Georginatoring/power_EMG_basic/README.md

# power_EMG_basic
Main PCB board for EMG signals
