Georginatoring/power_EMG_basic/V 2.0 EMG FSR/EMG FSR.brd

## EAGLE design V 2.0 EMG FSR/EMG FSR.brd (2021-03-11)

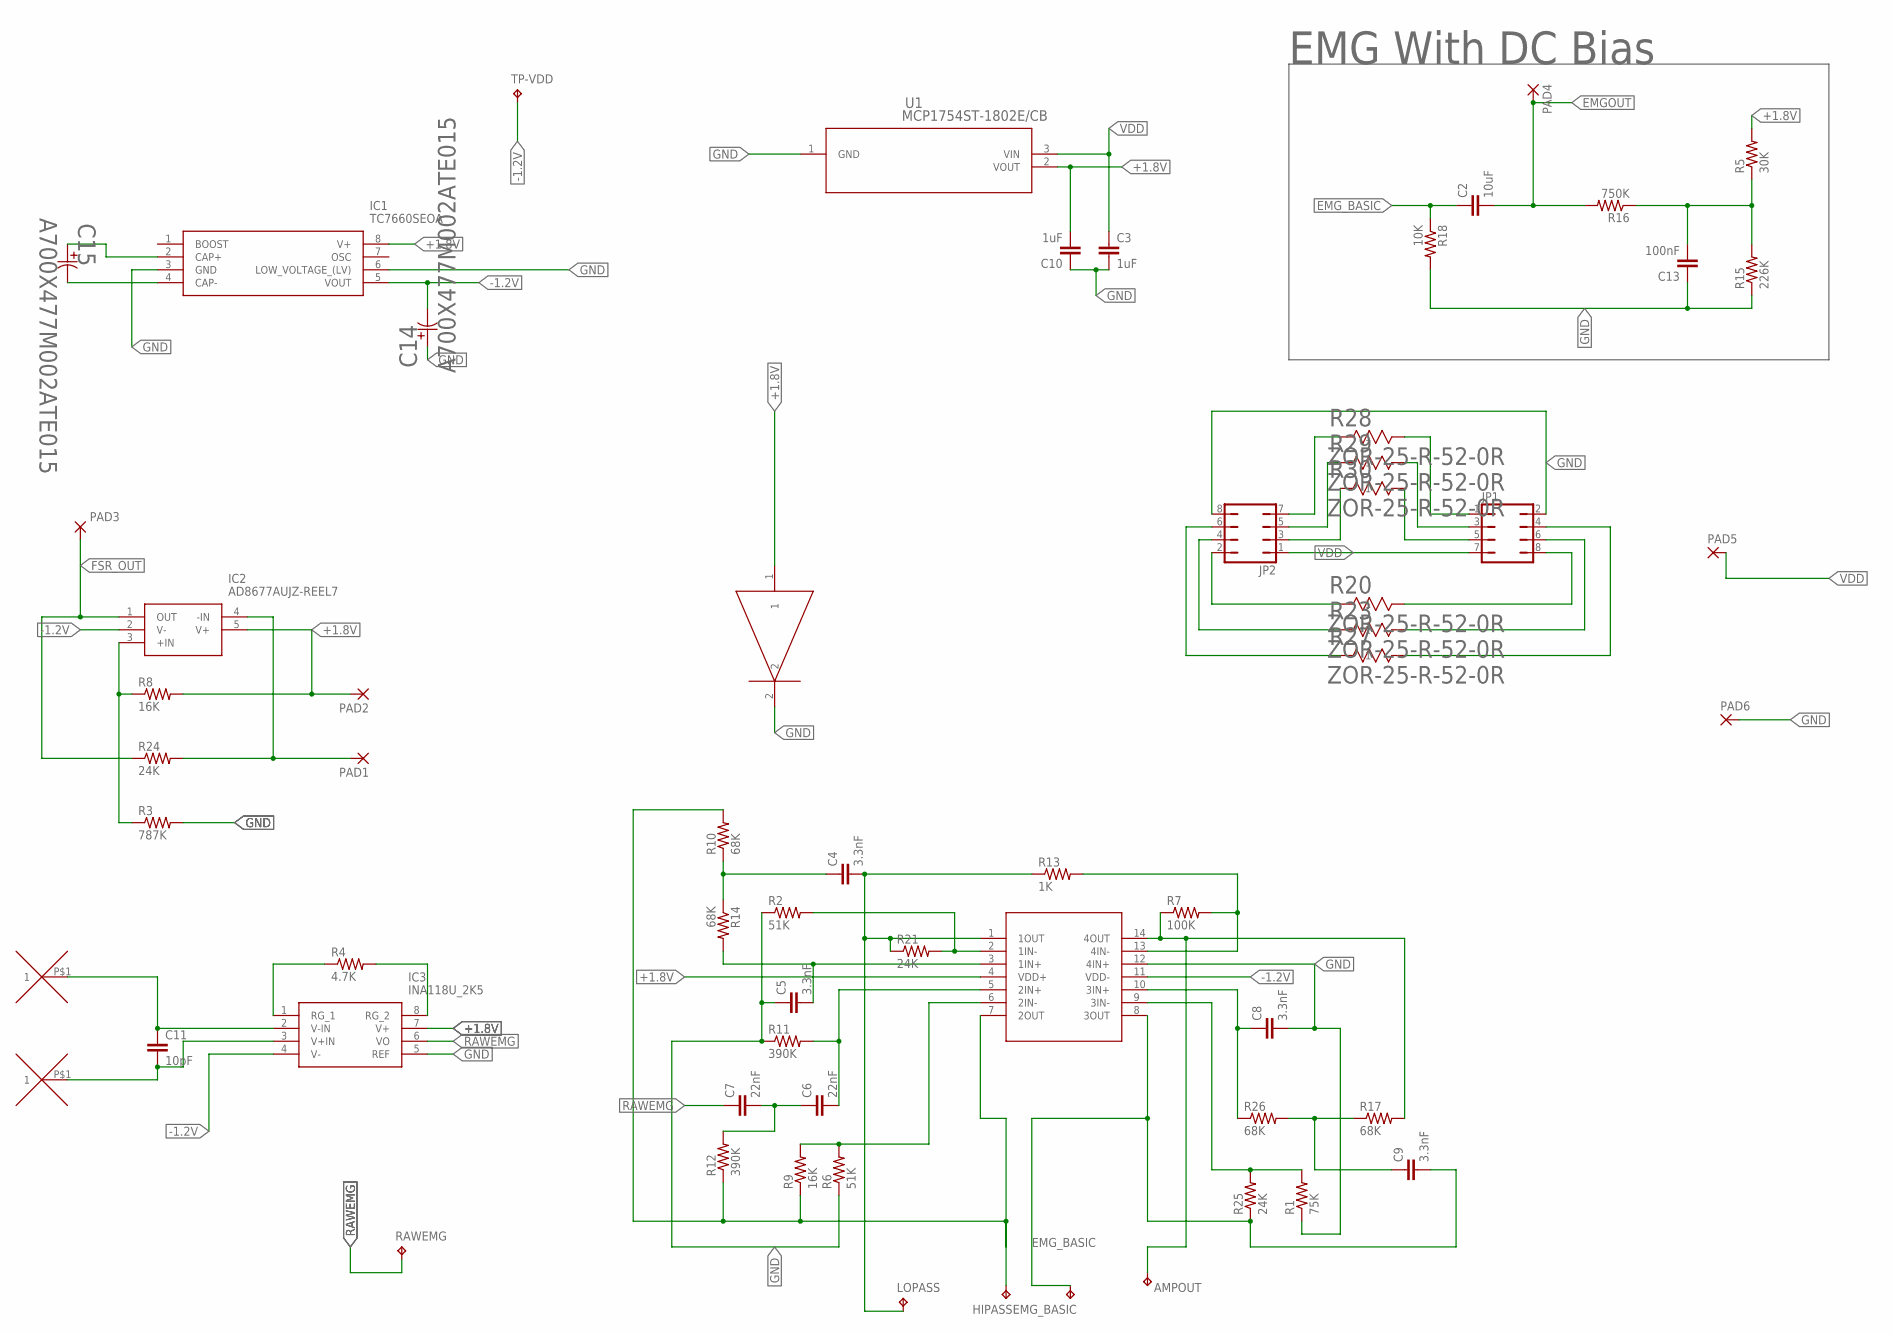
[picture p1: schematic EMG FSR.sch]

Parts:
AMPOUT: TPTP08R; TP08R
C2: 10uF; C0402
C3, C10: 1uF; C0402
C4, C5, C8, C9: 3.3nF; C1206
C6, C7: 22nF; C0805
C11: 10pF; C0402
C13: 100nF; C0402
C14, C15: A700X477M002ATE015; PCAP7343-43_KEMET_KEM
EMG_BASIC: TPTP08R; TP08R
HIPASS: TPTP08R; TP08R
IC1: TC7660SEOA; SOIC127P600X175-8N
IC2: AD8677AUJZ-REEL7; SOT95P280X100-5N
IC3: INA118U_2K5; SOIC127P600X175-8N
JP1, JP2: JP4Q
LOPASS: TPTP08R; TP08R
PAD1, PAD2: SMD2; SMD1,27-2,54
PAD3, PAD4, PAD5, PAD6: 1,6/0,8
R1: 75K; R0402
R2, R6: 51K; R0402
R3: 787K; R0805
R4: 4.7K; R0402
R5: 30K; R0402
R7: 100K; R1005
R8, R9: 16K; R0402
R10, R14, R17, R26: 68K; R0402
R11, R12: 390K; R0603
R13: 1K; R0402
R15: 226K; R0402
R16: 750K; R0402
R18: 10K; R0402
R20, R23, R27, R28, R29, R30: ZOR-25-R-52-0R; RES_ZOR25_6P3X2P3_YAG
R21, R24, R25: 24K; R0402
RAWEMG: TPTP08R; TP08R
RED: RESC0402X40N
TP-VDD: TPTP08R; TP08R
U1: MCP1754ST-1802E/CB; SOT-23A_MC_MCH
U$1: TLC2274-HT; SOP65P640X120-14N
U$2, U$3: EMG_VIA

Connections:
+1.8V: C10.2, IC1.8 (V+), IC2.5 (V+), IC3.7 (V+), PAD2.1, R5.2, R8.2, RED.1, U1.2 (VOUT), U$1.4 (VDD+)
-1.2V: C14.2, IC1.5 (VOUT), IC2.2 (V-), IC3.4 (V-), TP-VDD.TP, U$1.11 (VDD-)
EMGOUT: C2.2, PAD4.1, R16.2
EMG_BASIC: C2.1, C9.2, EMG_BASIC.TP, R18.1, R25.1, U$1.8 (3OUT)
FSR_OUT: IC2.1 (OUT), PAD3.1, R24.1
GND: C3.2, C5.1, C8.2, C10.1, C13.1, C14.1, IC1.3 (GND), IC1.6 (LOW_VOLTAGE_(LV)), IC3.5 (REF), JP1.2, JP2.8, PAD6.1, R1.1, R2.1, R3.2, R6.1, R11.1, R15.1, R18.2, RED.2, U1.1 (GND), U$1.12 (4IN+)
unnamed: C15.1, IC1.2 (CAP+)
unnamed: C15.2, IC1.4 (CAP-)
unnamed: C11.1, IC3.2 (V-IN), U$2.P$1
unnamed: C11.2, IC3.3 (V+IN), U$3.P$1
unnamed: IC2.4 (-IN), PAD1.1, R24.2
unnamed: C13.2, R5.1, R15.2, R16.1
unnamed: JP2.3, R30.1
unnamed: IC2.3 (+IN), R3.1, R8.1
unnamed: JP1.5, R30.2
unnamed: IC3.1 (RG_1), R4.1
unnamed: IC3.8 (RG_2), R4.2
unnamed: C4.2, LOPASS.TP, R13.1, R21.1, U$1.1 (1OUT)
unnamed: JP2.5, R29.1
unnamed: JP1.3, R29.2
unnamed: AMPOUT.TP, R7.1, R17.2, U$1.14 (4OUT)
unnamed: R7.2, R13.2, U$1.13 (4IN-)
unnamed: R2.2, R21.2, U$1.2 (1IN-)
unnamed: C5.2, R14.2, U$1.3 (1IN+)
unnamed: C4.1, R10.1, R14.1
unnamed: JP1.1, R28.2
unnamed: C6.1, C7.2, R12.2
unnamed: C6.2, R11.2, U$1.5 (2IN+)
unnamed: JP2.7, R28.1
unnamed: R6.2, R9.2, U$1.6 (2IN-)
unnamed: C9.1, R17.1, R26.2
unnamed: C8.1, R26.1, U$1.10 (3IN+)
unnamed: JP2.2, R20.1
unnamed: R1.2, R25.2, U$1.9 (3IN-)
unnamed: JP1.8, R20.2
unnamed: JP1.6, R23.2
unnamed: JP2.4, R23.1
unnamed: JP2.6, R27.1
unnamed: JP1.4, R27.2
PIN7: HIPASS.TP, R9.1, R10.2, R12.1, U$1.7 (2OUT)
RAWEMG: C7.1, IC3.6 (VO), RAWEMG.TP
VDD: C3.1, JP1.7, JP2.1, PAD5.1, U1.3 (VIN)

Notes on the sheet:
EMG With DC Bias

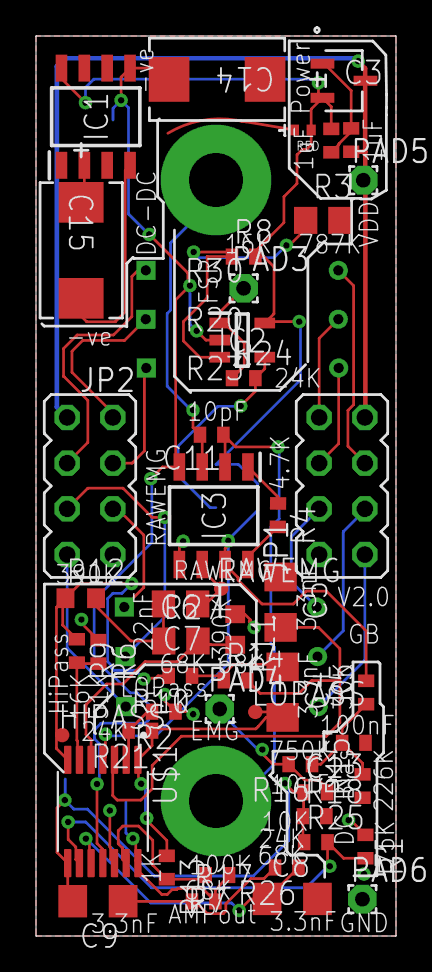
[picture p2: board EMG FSR.brd from above]

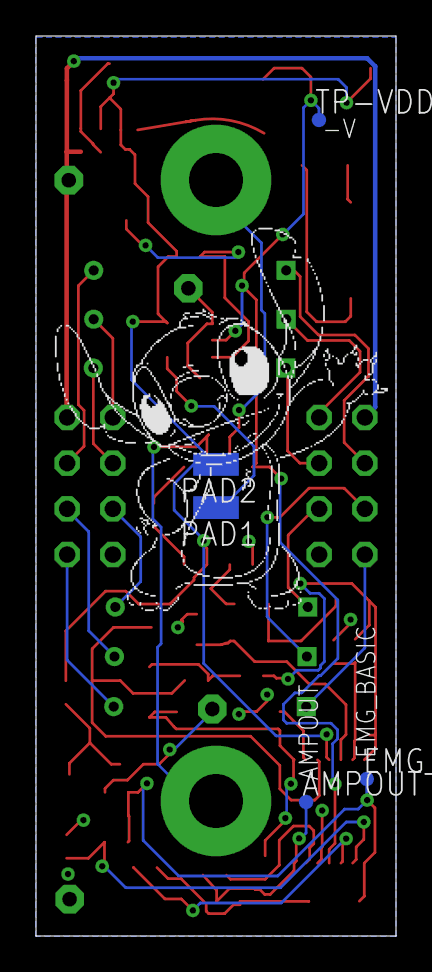
[picture p3: board EMG FSR.brd from below]

Board: 2 copper layers, 20.0 x 50.0 mm, 63 parts (5 on the bottom side), 42 nets.
