Georginatoring/power_EMG_basic/V1.1_Project/New_Project/EMG_FSR.brd

## EAGLE design V1.1_Project/New_Project/EMG_FSR.brd (2020-10-05)

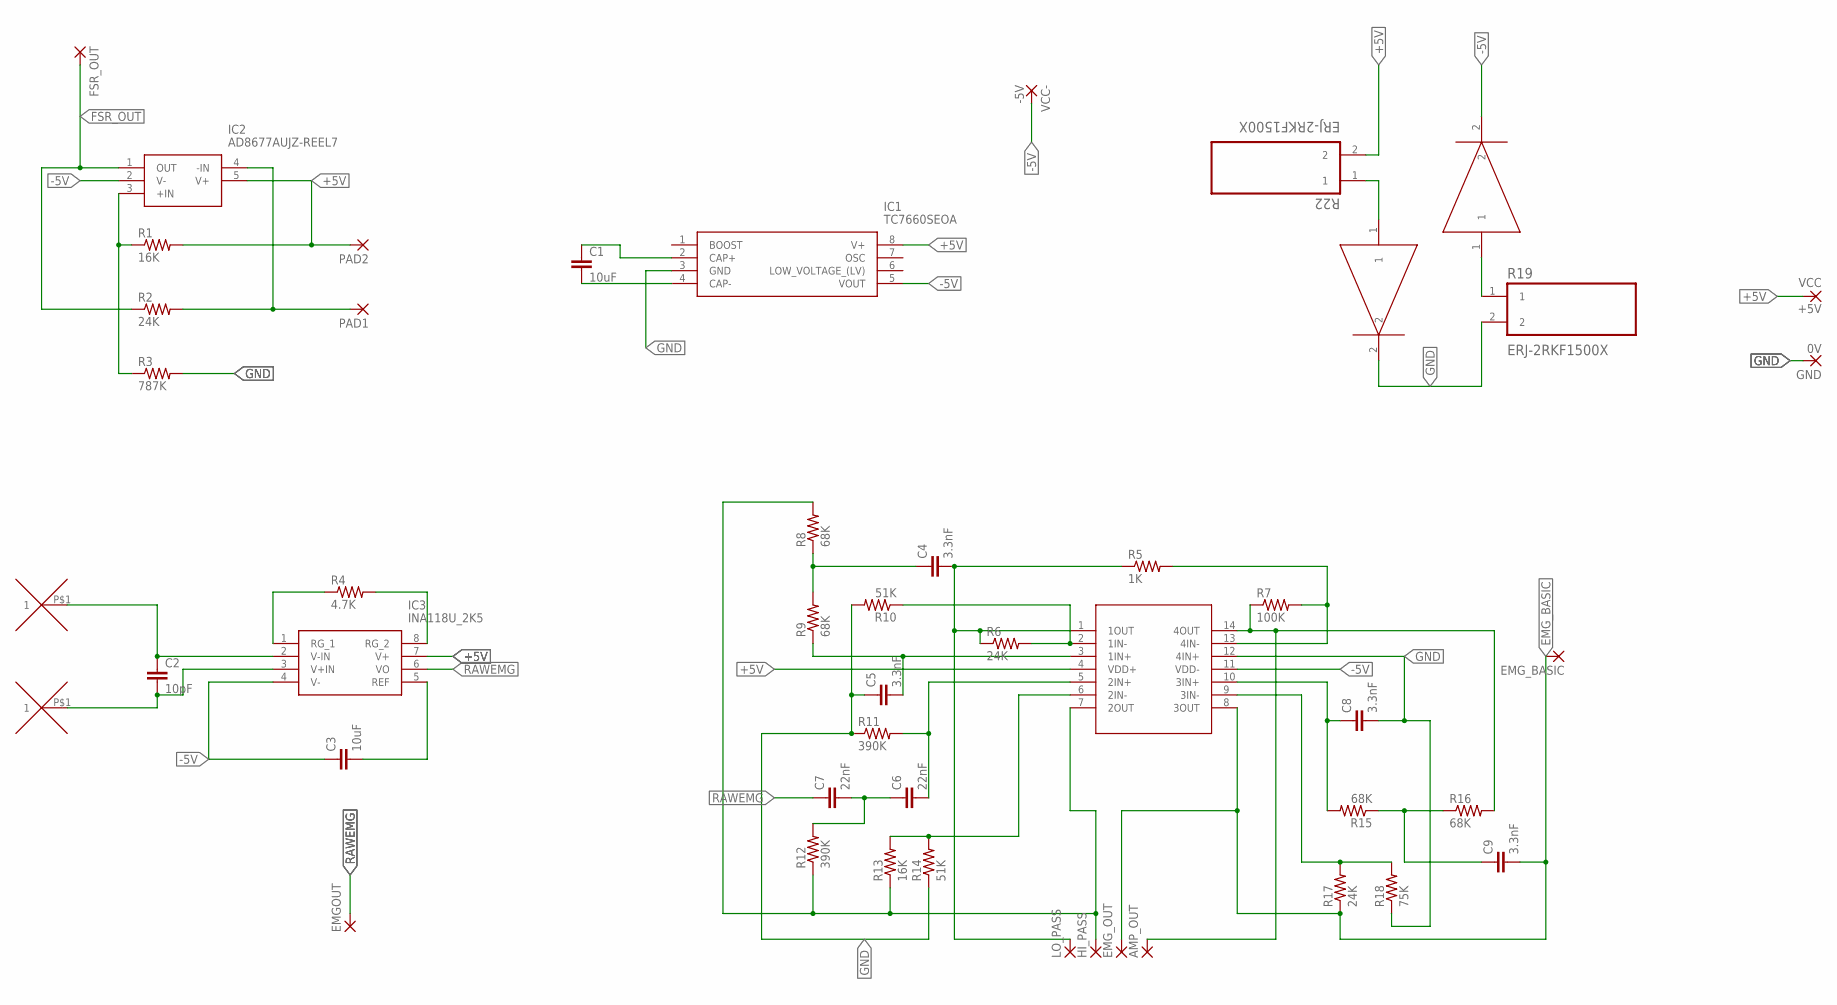
[picture p4: schematic EMG_FSR.sch]

Parts:
AMP_OUT: 1,6/0,8
C1: 10uF; C0603K
C2: 10pF; C0402K
C3: 10uF; C0402K
C4, C5, C8, C9: 3.3nF; C1206
C6, C7: 22nF; C0805
EMGOUT: 1,6/0,8
EMG_BASIC: 1,6/0,8
EMG_OUT: 1,6/0,8
FSR_OUT: 1,6/0,8
GND: 0V; 1,6/0,8
HI_PASS: 1,6/0,8
IC1: TC7660SEOA; SOIC127P600X175-8N
IC2: AD8677AUJZ-REEL7; SOT95P280X100-5N
IC3: INA118U_2K5; SOIC127P600X175-8N
LO_PASS: 1,6/0,8
PAD1, PAD2: SMD2; SMD1,27-2,54
R1: 16K; R0402
R2: 24K; R0402
R3: 787K; R0805
R4: 4.7K; R0402
R5: 1K; R0201
R6, R17: 24K; R0201
R7: 100K; R1005
R8, R9, R15, R16: 68K; R0201
R10, R14: 51K; R0201
R11, R12: 390K; R0603
R13: 16K; R0201
R18: 75K; R0201
R19, R22: ERJ-2RKF1500X; RESC1005X40N
R20: RESC0402X40N
RED: RESC0402X40N
U$1: TLC2274-HT; SOP65P640X120-14N
U$2, U$3: EMG_VIA
VCC: +5V; 1,6/0,8
VCC-: -5V; 1,6/0,8

Connections:
+5V: IC1.8 (V+), IC2.5 (V+), IC3.7 (V+), PAD2.1, R1.2, R22.2, U$1.4 (VDD+), VCC.1
-5V: C3.1, IC1.5 (VOUT), IC2.2 (V-), IC3.4 (V-), R20.2, U$1.11 (VDD-), VCC-.1
EMG_BASIC: C9.2, EMG_BASIC.1, EMG_OUT.1, R17.1, U$1.8 (3OUT)
FSR_OUT: FSR_OUT.1, IC2.1 (OUT), R2.1
GND: C5.1, C8.2, GND.1, IC1.3 (GND), R3.2, R10.2, R11.1, R14.1, R18.1, R19.2, RED.2, U$1.12 (4IN+)
unnamed: C1.1, IC1.2 (CAP+)
unnamed: C1.2, IC1.4 (CAP-)
unnamed: C2.1, IC3.2 (V-IN), U$2.P$1
unnamed: R22.1, RED.1
unnamed: C2.2, IC3.3 (V+IN), U$3.P$1
unnamed: R19.1, R20.1
unnamed: IC2.4 (-IN), PAD1.1, R2.2
unnamed: IC2.3 (+IN), R1.1, R3.1
unnamed: C3.2, IC3.5 (REF)
unnamed: IC3.1 (RG_1), R4.1
unnamed: IC3.8 (RG_2), R4.2
unnamed: C4.2, LO_PASS.1, R5.1, R6.1, U$1.1 (1OUT)
unnamed: AMP_OUT.1, R7.1, R16.2, U$1.14 (4OUT)
unnamed: R5.2, R7.2, U$1.13 (4IN-)
unnamed: R6.2, R10.1, U$1.2 (1IN-)
unnamed: C5.2, R9.1, U$1.3 (1IN+)
unnamed: C4.1, R8.1, R9.2
unnamed: C6.1, C7.2, R12.2
unnamed: C6.2, R11.2, U$1.5 (2IN+)
unnamed: R13.2, R14.2, U$1.6 (2IN-)
unnamed: C9.1, R15.1, R16.1
unnamed: C8.1, R15.2, U$1.10 (3IN+)
unnamed: R17.2, R18.2, U$1.9 (3IN-)
PIN7: HI_PASS.1, R8.2, R12.1, R13.1, U$1.7 (2OUT)
RAWEMG: C7.1, EMGOUT.1, IC3.6 (VO)

Board: 2 copper layers, 49 parts (4 on the bottom side), 30 nets, no tracks yet.
