Georginatoring/power_EMG_basic/(commit log)

2020-10-05 Add files via upload
    V1.1 & libraries
    [EMG_FSR.brd, EMG_FSR.sch, IMU.sch]
2020-10-05 Set EMG Electrode Locations
2020-10-05 Located Some Parts
    [EMG_FSR.brd]
2021-03-11 Add files via upload
    version 2 EMG & FSR
    [EMG FSR.brd, EMG FSR.sch, protection.sch]
