Georginatoring/power_EMG_basic/(notices)

Notices in the files:
parts and their libraries:
MCP1754ST: COPYRIGHT: Copyright (C) 2018 Accelerated Designs. All rights reserved
